RockingRidz/StreamPixel/PCB/StreamPixel-perfboard.pdf

1 | 2 | 3 | 4 | 5 | 6 | 7 | 8
1 | 2 | 3 | 4 | 5 | 6 | 7 | 8

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
Size: A3 | Rev: 1 | F Date: 2026-11-01
KiCad E.D.A. 10.0.6 | Id: 1/1

# Title: StreamPixel - development-board / perfboard wiring

## File: StreamPixel-perfboard.kicad_sch

## Sheet: /

## Ridith Shetty

NO CUSTOM PCB REQUIRED. Logical module pin labels; verify actual hardware.

GND GND | OUT | OUT VCC VCC | U4 MAX9814 - follow printed pin labels 1

2

J6 Panel 2 DC power lead

C3

## 470uF 25V - polarity matters F3

5A candidate - verify branch load

C1

## 100nF at U2 pins20/10

1
2
3
J4 PIN8: select GND OR E after verification | 1

2

J7 Panel 3 DC power lead

F4

5A candidate - verify branch load

C2

## 100nF at U3 pins20/10

1
2

J5 Panel 1 DC power lead

1 | 2
3 | 4
5 | 6
7 | 8
9 | 10
11 | 12
13 | 14
15 | 16

## J1 HUB75 PANEL 1 IN - VERIFY PINOUT

F2

5A candidate - verify branch load

3V3 3V3 | 5V/VIN 5V | GND GND | GPIO13 | GPIO13 GPIO14 | GPIO14 GPIO16 | GPIO16 GPIO17 | GPIO17 GPIO18 | GPIO18 GPIO19 | GPIO19 GPIO21 | GPIO21 GPIO22 | GPIO22 GPIO23 | GPIO23 GPIO25 | GPIO25 GPIO26 | GPIO26 GPIO27 | GPIO27 GPIO32 | GPIO32 GPIO33 GPIO34_ADC1 | GPIO33 GPIO34 | U1

## ESP32 30-pin dev board - GPIO LABELS

DIR 1 | A1 2 | A2 3 | A3 4 | A4 5 | A5 6 | A6 7 | A7 8 | A8 9 | GND 10 | B8 | 11 B7 | 12 B6 | 13 B5 | 14 B4 | 15 B3 | 16 B2 | 17 B1 | 18 OE 19 | VCC 20 U2
SN74HCT245N (A-to-B) DIR 1 | A1 2 | A2 3 | A3 4 | A4 5 | A5 6 | A6 7 | A7 8 | A8 9 | GND 10 | B8 | 11 B7 | 12 B6 | 13 B5 | 14 B4 | 15 B3 | 16 B2 | 17 B1 | 18 OE 19 | VCC 20 U3

## SN74HCT245N (A-to-B) R1

## 10k OE blank at reset 1

2

J2

## 5V DC from protected supply - NO MAINS HERE

F1

1A controller

ADDR_A | R1 | G1 B1R2 | GND
B2 | G2
ADDR_A GPIO14 | GND

ADDR_C

CLK

PANEL_PIN8 | +5V_CTRL GND

GND

GND

ADDR_E | +5V_CTRL +3V3 GND

GND

PANEL3_5V

+5V_CTRL

PANEL1_5V | +5V_SUPPLY

+5V_CTRL

PANEL2_5V GND

GPIO33

PANEL2_5V

GND

# PANEL3_5V +5V_SUPPLY

GPIO25 | MIC_AUDIO

GND

GND

GND

PANEL_PIN8

ADDR_B

ADDR_D

+5V_CTRL

GPIO26

+5V_SUPPLY

GPIO27 | GND

PANEL1_5V

MIC_AUDIO

G1 GPIO13 GPIO32 GPIO23 GPIO19 GPIO18 GPIO21 GPIO16 GPIO17 GPIO22 | GND
GND +5V_CTRL GPIO21 GPIO16 +5V_CTRL GPIO23 GPIO19 | +5V_CTRL | R1

ADDR_B

GPIO25 | B1

LAT R2 GPIO27 GPIO14 GPIO13 GPIO32 +5V_CTRL GND

GND

GPIO18 +3V3

ADDR_C

ADDR_D

CLK

LAT DISPLAY_OE

GPIO26 GPIO17 GPIO22 GPIO33 +3V3 GPIO22

G2

GND +5V_SUPPLY +5V_SUPPLY

DISPLAY_OE B2

+5V_SUPPLY +5V_CTRL GND

ADDR_E 5V buffer outputs NEVER connect to ESP32 inputs. U2/U3 must be HCT parts, not HC-only replacements.

Panel OUT -> next panel IN. Separate fused power to every panel. Do not carry panel current through perfboard.

J4 stays open until panel pin8 is identified. Never bridge both positions or ground a driven E output. MAX9814 powered at 3.3V; verify actual output range before connecting GPIO34 (ADC1).

# StreamPixel | Ridith Shetty | PERFBOARD BUILD - NO PCB ORDER

Supply case and terminals require suitable protection, earth and strain relief. This sheet covers LOW-VOLTAGE DC wiring only. Disconnect external supply and display harness for USB programming unless dev-board power isolation is documented.

GPIO labels are logical connections, NOT a physical 30-pin header drawing. Verify the actual board labels.
