RockingRidz/StreamPixel/BOM.csv

Item | Qty | Supplier | Cost/item | Total Cost | link
P10 RGB 2727 320x160 panel | 3 | Koshi | $6.85 | $20.55 | https://koshielectronics.in/products/p10-rgb-led-module?variant=43978032611524
5V 20A slim SMPS | 1 | Koshi | $5.78 | $5.78 | https://koshielectronics.in/products/xps-smps-5v-10a?variant=44089885327556
Nylon Cable Tie / Wire Tag 200X3.6mm (Pack of 100) | 1 | Quartz | $1.04 | $1.04 | https://quartzcomponents.com/products/tie-250x3-6-100-pc-in-each?variant=44025622003946
M3 x 8mm Flat SS Washer (Inner Dia. 3mm) | 24 | Quartz | $0.02 | $0.48 | https://quartzcomponents.com/products/m3-zinc-plated-steel-washer?variant=45646474346730
M3-15mm Bolt with Phillips Head (Mounting Screw) - Pack of 4 | 1 | Quartz | $0.08 | $0.08 | https://quartzcomponents.com/products/phillips-head-m3-15mm-bolt-mounting-screw-for-pcb-pack-of-4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
Phillips Head M3- 25mm bolt (Mounting Screw for PCB) - Pack of 4 | 1 | Quartz | $0.11 | $0.11 | https://quartzcomponents.com/products/phillips-head-m3-25mm-bolt-mounting-screw-for-pcb-pack-of-4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
MAX9814 High Performance AGC Microphone Amplifier Module CMA-4544PF-W | 1 | Quartz | $2.33 | $2.33 | https://quartzcomponents.com/products/max9814-agc-microphone-amplifier-module-cma-4544pf-w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
M3 Hex Nut with 2mm height (pack of 4) | 8 | Quartz | $0.12 | $0.96 | https://quartzcomponents.com/products/m3-hex-nut-with-2mm-height-pack-of-4?variant=42673973133546
M3-10mm Bolt with Phillips Head(Mounting Screw for PCB) - Pack of 4 | 6 | Quartz | $0.08 | $0.48 | https://quartzcomponents.com/products/phillips-head-m3-10mm-bolt-mounting-screw-for-pcb?variant=42673975886058
PG9 Cable Gland Connector (DIA-15mm)- Plastic Nylon Gland - Black | 1 | Quartz | $0.05 | $0.05 | https://quartzcomponents.com/products/pg9-cable-gland-connector-dia-15mm-plastic-nylon-gland-black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
Heat Shrink Sleeve Tube - 5mm Diameter - Black - 1 meter | 1 | Quartz | $0.20 | $0.20 | https://quartzcomponents.com/products/heat-shrink-tube-5mm-diameter-black-1-meter?variant=37554769756344
1A Glass Fuse - 5x20mm | 1 | Quartz | $0.05 | $0.05 | https://quartzcomponents.com/products/1a-glass-fuse-5x20mm?variant=31898062028935
5A Glass Fuse - 5x20mm | 3 | Quartz | $0.04 | $0.12 | https://quartzcomponents.com/products/5a-glass-fuse-5x20mm?variant=31898062684295
Panel Mount 5A Fuse Holder (5x20MM) | 4 | Quartz | $0.19 | $0.76 | https://quartzcomponents.com/products/panel-mount-5a-fuse-holder-5x20mm?variant=40656589029560
3 Pin Power Supply AC Extension Cord Power Cable 180v to 240v AC 10A - 1.3 meter | 1 | Quartz | $1.42 | $1.42 | https://quartzcomponents.com/products/3-pin-power-supply-ac-extension-cord-power-cable-180v-to-240v-ac-10a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
18AWG Silicone Wire Black ( 1 meter ) - High Quality Ultra Flexible for Battery Packs | 2 | Quartz | $0.44 | $0.88 | https://quartzcomponents.com/products/high-quality-ultra-flexible-18awg-silicone-wire-black-1-meter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
18AWG Silicone Wire Red ( 1 meter ) - High Quality Ultra Flexible for Battery Packs | 2 | Quartz | $0.44 | $0.88 | https://quartzcomponents.com/products/high-quality-ultra-flexible-18awg-silicone-wire-red-1-meter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
23AWG Single Strand Breadboard Connecting Wire (Black and Red - 1+1 Meter) | 1 | Quartz | $0.26 | $0.26 | https://quartzcomponents.com/products/breadboard-connecting-wires-1-1-meter?variant=32394483105927
Samwha 470uF 25V 85 Degree Radial Electrolytic Capacitor - Through Hole | 1 | Quartz | $0.08 | $0.08 | https://quartzcomponents.com/products/samwha-470uf-25v-85-c-radial-electrolytic-capacitor-through-hole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
10K ohm, 1/4 Watt Resistor with 5% tolerance (Pack of 10) | 1 | Quartz | $0.07 | $0.07 | https://quartzcomponents.com/products/10k-ohm-1-4-watt-resistor?variant=31898016710791
40 Pin Straight Female Header Pins - Berg Strips | 1 | Quartz | $0.11 | $0.11 | https://quartzcomponents.com/products/40-pin-straight-female-berg-strips?variant=31898065830023
40 Pin Straight Male Header Pins - Berg Strips | 1 | Quartz | $0.07 | $0.07 | https://quartzcomponents.com/products/40-pin-break-away-headers-straight-male-headers?variant=31898065633415
100nF / 0.1uF (104) 50V 1206 SMD Capacitor (Pack of 10 Pieces) | 1 | Quartz | $0.17 | $0.17 | https://quartzcomponents.com/products/100nf-0-1uf-104-50v-1206-smd-capacitor-pack-of-10-pieces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
USB to micro-USB Cable for NodeMCU and Raspberry Pi | 1 | Quartz | $0.34 | $0.34 | https://quartzcomponents.com/products/raspberry-pi-cable-for-charging?variant=31897766428807
9x15cm Double Sided Universal PCB Prototype Board | 1 | Quartz | $1.14 | $1.14 | https://quartzcomponents.com/products/double-sided-universal-pcb-prototype-board-9x15cm?variant=45108700840170
ESP32 30 Pin CP2102 Development Board with Wi-Fi and Bluetooth | 1 | Quartz | $3.95 | $3.95 | https://quartzcomponents.com/products/esp32-30-pin-development-board-with-wi-fi-and-bluetooth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
SN74HCT245N DIP20 | 2 | Industrybuying | $1.47 | $2.94 | https://www.industrybuying.com/industrial-automation-accessories-texas-instruments-IND.IND.231558858
Buffer cart delivery | 1 | Industrybuying | $3.14 | $3.14 | https://www.industrybuying.com/order/cart
Estimated total shipping | 1 |  |  | $19.00
