RockingRidz/StreamPixel/CAD/CNC/Whole-frame-990x190x60.step

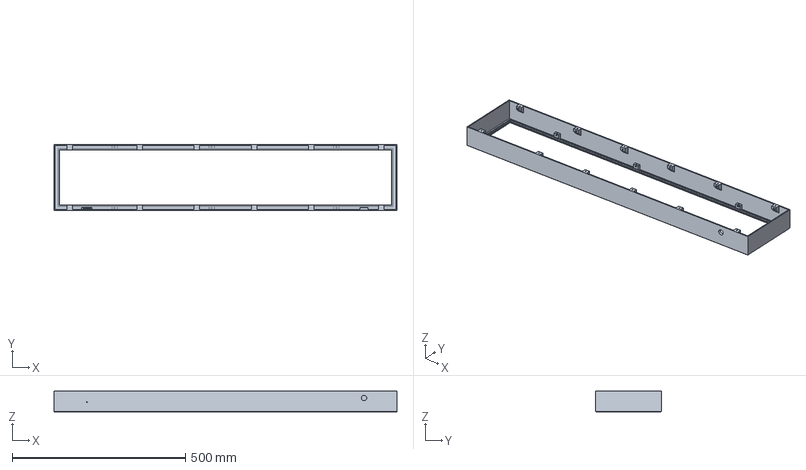
[picture p5: CAD file, 2026-11-01]
CAD/CNC/Whole-frame-990x190x60.step
990.0 x 190.0 x 60.0 mm
