RockingRidz/StreamPixel/CAD/CNC/REFERENCE-ONLY-frame-overall.dxf

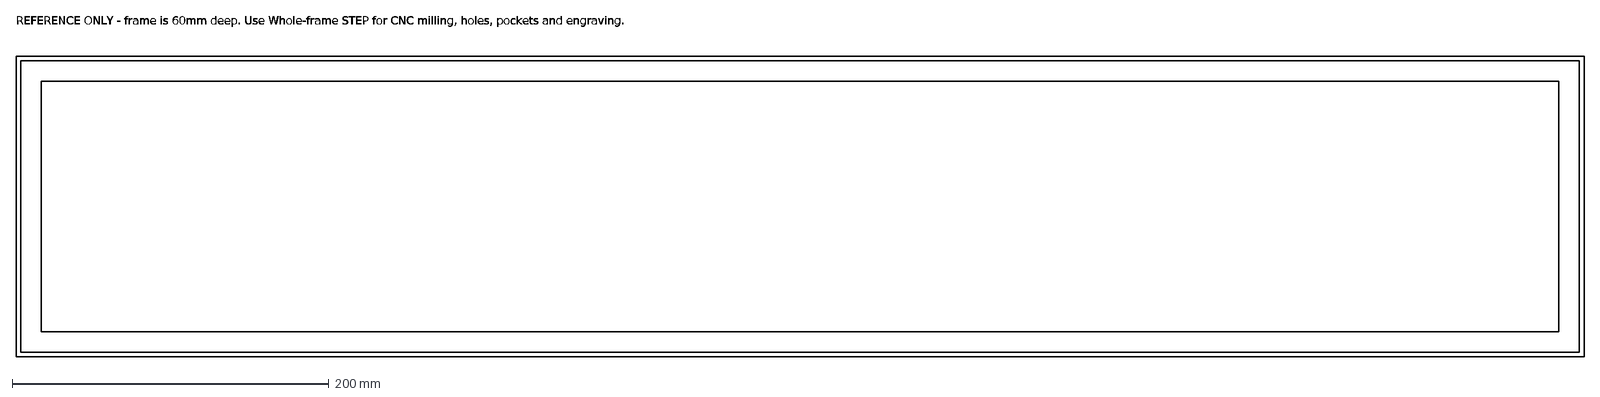
[picture p6: CAD file, 2026-11-01]
CAD/CNC/REFERENCE-ONLY-frame-overall.dxf
REFERENCE ONLY - frame is 60mm deep. Use Whole-frame STEP for CNC milling, holes, pockets and engraving.
