RockingRidz/StreamPixel/CAD/CNC/Whole-backplate-990x190x3.step

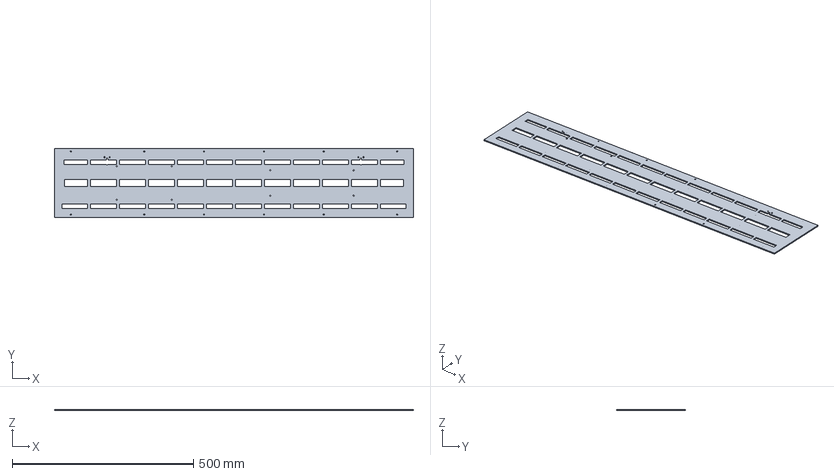
[picture p7: CAD file, 2026-11-01]
CAD/CNC/Whole-backplate-990x190x3.step
990.0 x 190.0 x 3.00 mm
