RockingRidz/StreamPixel/CAD/3D_PRINTED/Supply-holder-right.step

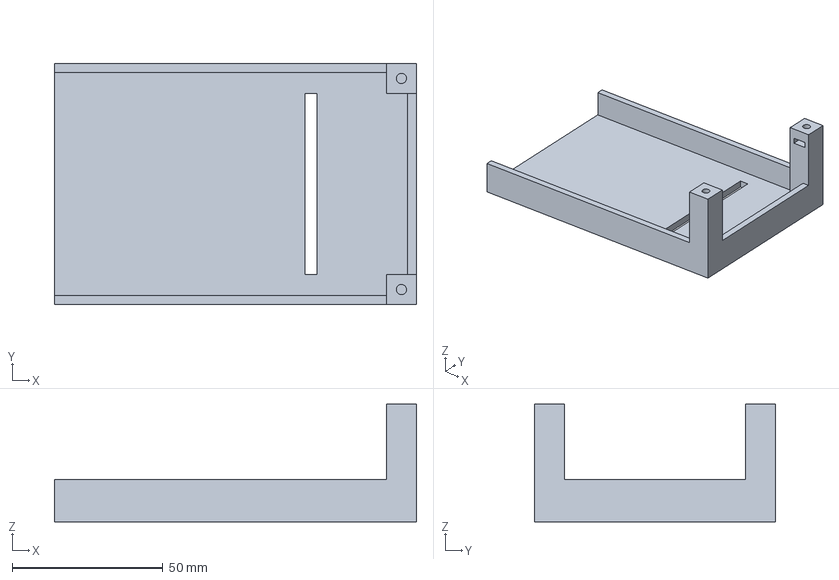
[picture p8: CAD file, 2026-11-01]
CAD/3D_PRINTED/Supply-holder-right.step
120.0 x 80.0 x 39.0 mm
