RockingRidz/StreamPixel/CAD/SOURCE/StreamPixel-Ridith-Shetty.FCStd

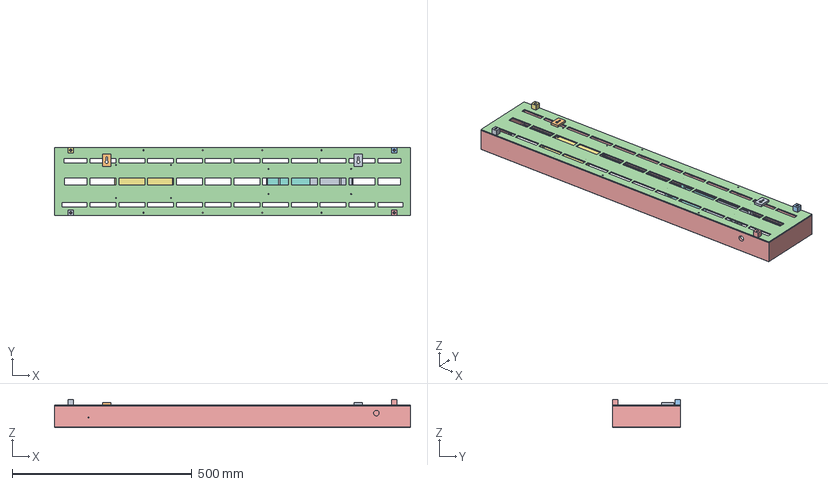
[picture p9: CAD file, 2026-11-01]
CAD/SOURCE/StreamPixel-Ridith-Shetty.FCStd
990.0 x 190.0 x 78.0 mm
Hanger-pad-X350-Y59
Hanger-pad-X-350-Y59
Panel-retainer-X320-Y83
Whole-backplate-990x190x3
Whole-frame-990x190x60
Panel-retainer-X-40-Y-83
Wall-spacer-X-450-Y87
Panel-retainer-X320-Y-83
Wall-spacer-X-450-Y-87
Panel-retainer-X-40-Y83
Wall-spacer-X450-Y87
Panel-retainer-X-320-Y83
Wall-spacer-X450-Y-87
Panel-retainer-X-320-Y-83
Controller-tray
Supply-holder-left
Supply-holder-right
