RockingRidz/StreamPixel/CAD/CNC/Hanger-pad-X-350-Y59.step

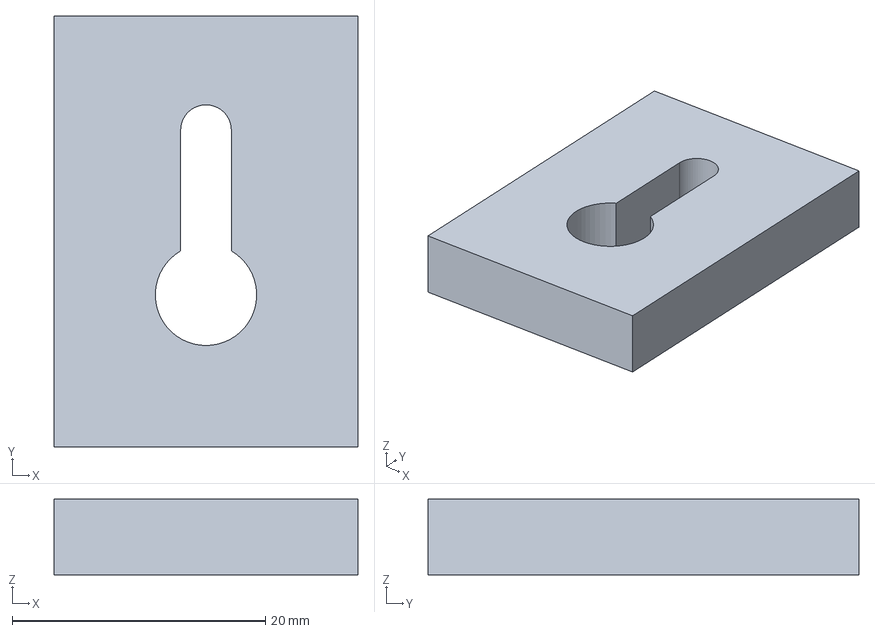
[picture p10: CAD file, 2026-11-01]
CAD/CNC/Hanger-pad-X-350-Y59.step
24.0 x 34.0 x 6.00 mm
