RockingRidz/StreamPixel/CAD/SOURCE/CNC-components.step

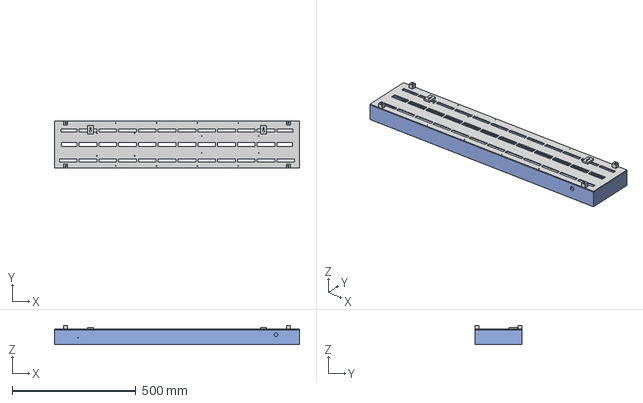
[picture p11: CAD file, 2026-11-01]
CAD/SOURCE/CNC-components.step
990.0 x 190.0 x 78.0 mm
