RockingRidz/StreamPixel/CAD/3D_PRINTED/Controller-tray.step

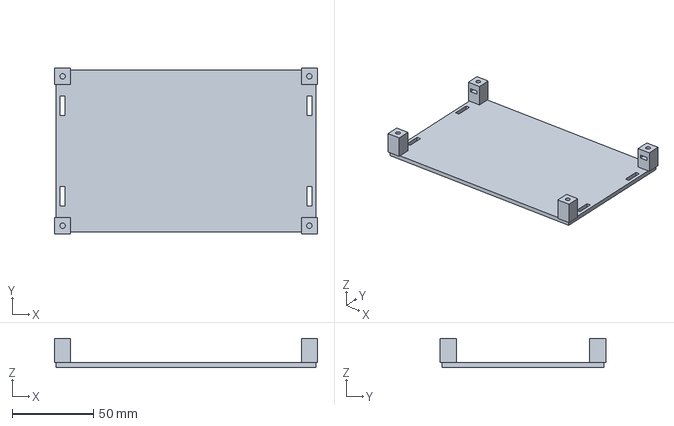
[picture p12: CAD file, 2026-11-01]
CAD/3D_PRINTED/Controller-tray.step
162.0 x 102.0 x 18.0 mm
