RockingRidz/StreamPixel/CAD/CNC/Panel-retainer-X-320-Y-83.step

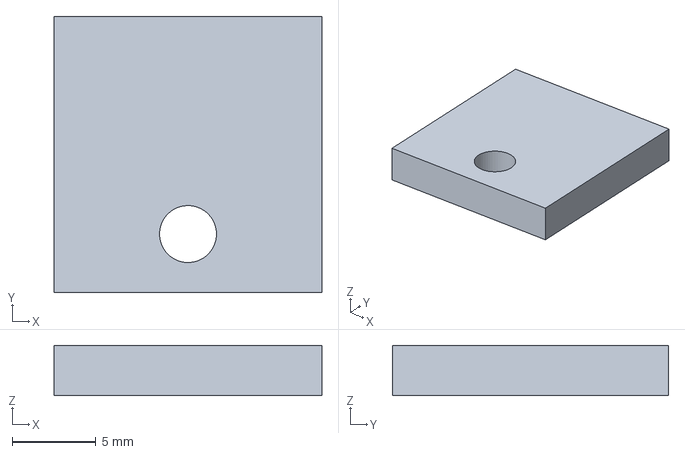
[picture p13: CAD file, 2026-11-01]
CAD/CNC/Panel-retainer-X-320-Y-83.step
16.0 x 16.5 x 3.00 mm
