RockingRidz/StreamPixel/CAD/SOURCE/PRINT-holders.step

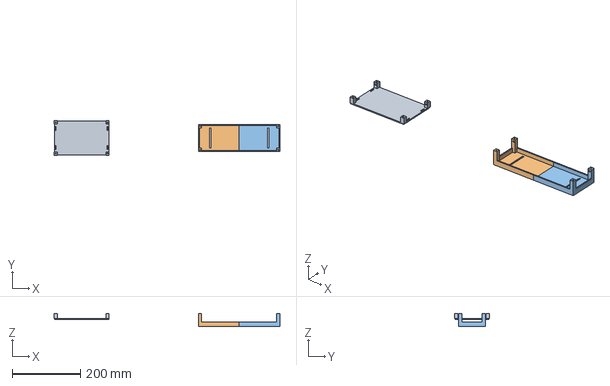
[picture p14: CAD file, 2026-11-01]
CAD/SOURCE/PRINT-holders.step
663.5 x 102.0 x 39.0 mm
