RockingRidz/StreamPixel/CAD/CNC/Wall-spacer-X-450-Y-87.step

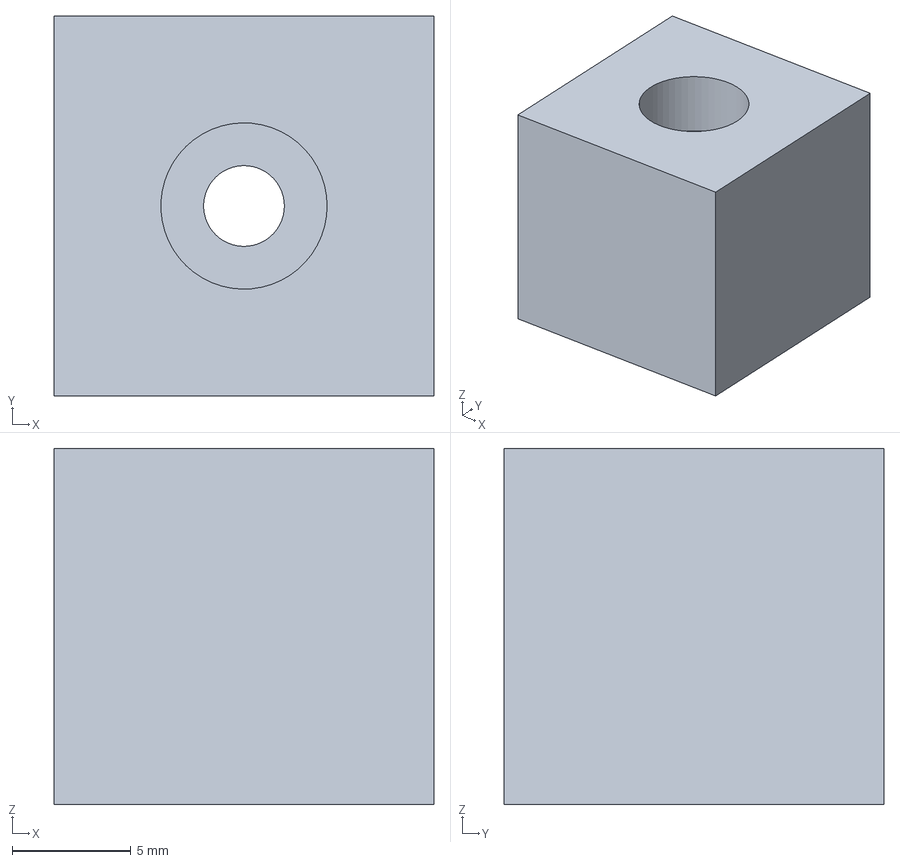
[picture p15: CAD file, 2026-11-01]
CAD/CNC/Wall-spacer-X-450-Y-87.step
16.0 x 16.0 x 15.0 mm
