RockingRidz/StreamPixel/(list of files, cad)

Other CAD files:
CAD/3D_PRINTED/Supply-holder-left.step
CAD/CNC/Panel-retainer-X-40-Y-83.step
CAD/3D_PRINTED/Controller-tray.stl
CAD/3D_PRINTED/Supply-holder-left.stl
CAD/3D_PRINTED/Supply-holder-right.stl
CAD/CNC/Hanger-pad-X350-Y59.step
CAD/CNC/Panel-retainer-X-320-Y-83.dxf
CAD/CNC/Panel-retainer-X-320-Y83.dxf
CAD/CNC/Panel-retainer-X-320-Y83.step
CAD/CNC/Panel-retainer-X-40-Y-83.dxf
CAD/CNC/Panel-retainer-X-40-Y83.dxf
CAD/CNC/Panel-retainer-X-40-Y83.step
CAD/CNC/Panel-retainer-X320-Y-83.dxf
CAD/CNC/Panel-retainer-X320-Y-83.step
CAD/CNC/Panel-retainer-X320-Y83.dxf
CAD/CNC/Panel-retainer-X320-Y83.step
CAD/CNC/Wall-spacer-X-450-Y87.step
CAD/CNC/Wall-spacer-X450-Y-87.step
CAD/CNC/Wall-spacer-X450-Y87.step
CAD/CNC/Whole-backplate-990x190x3.dxf
