RockingRidz/StreamPixel/PCB/StreamPixel-perfboard.kicad_sch

## KiCad design PCB/StreamPixel-perfboard.kicad_sch (2026-11-01)

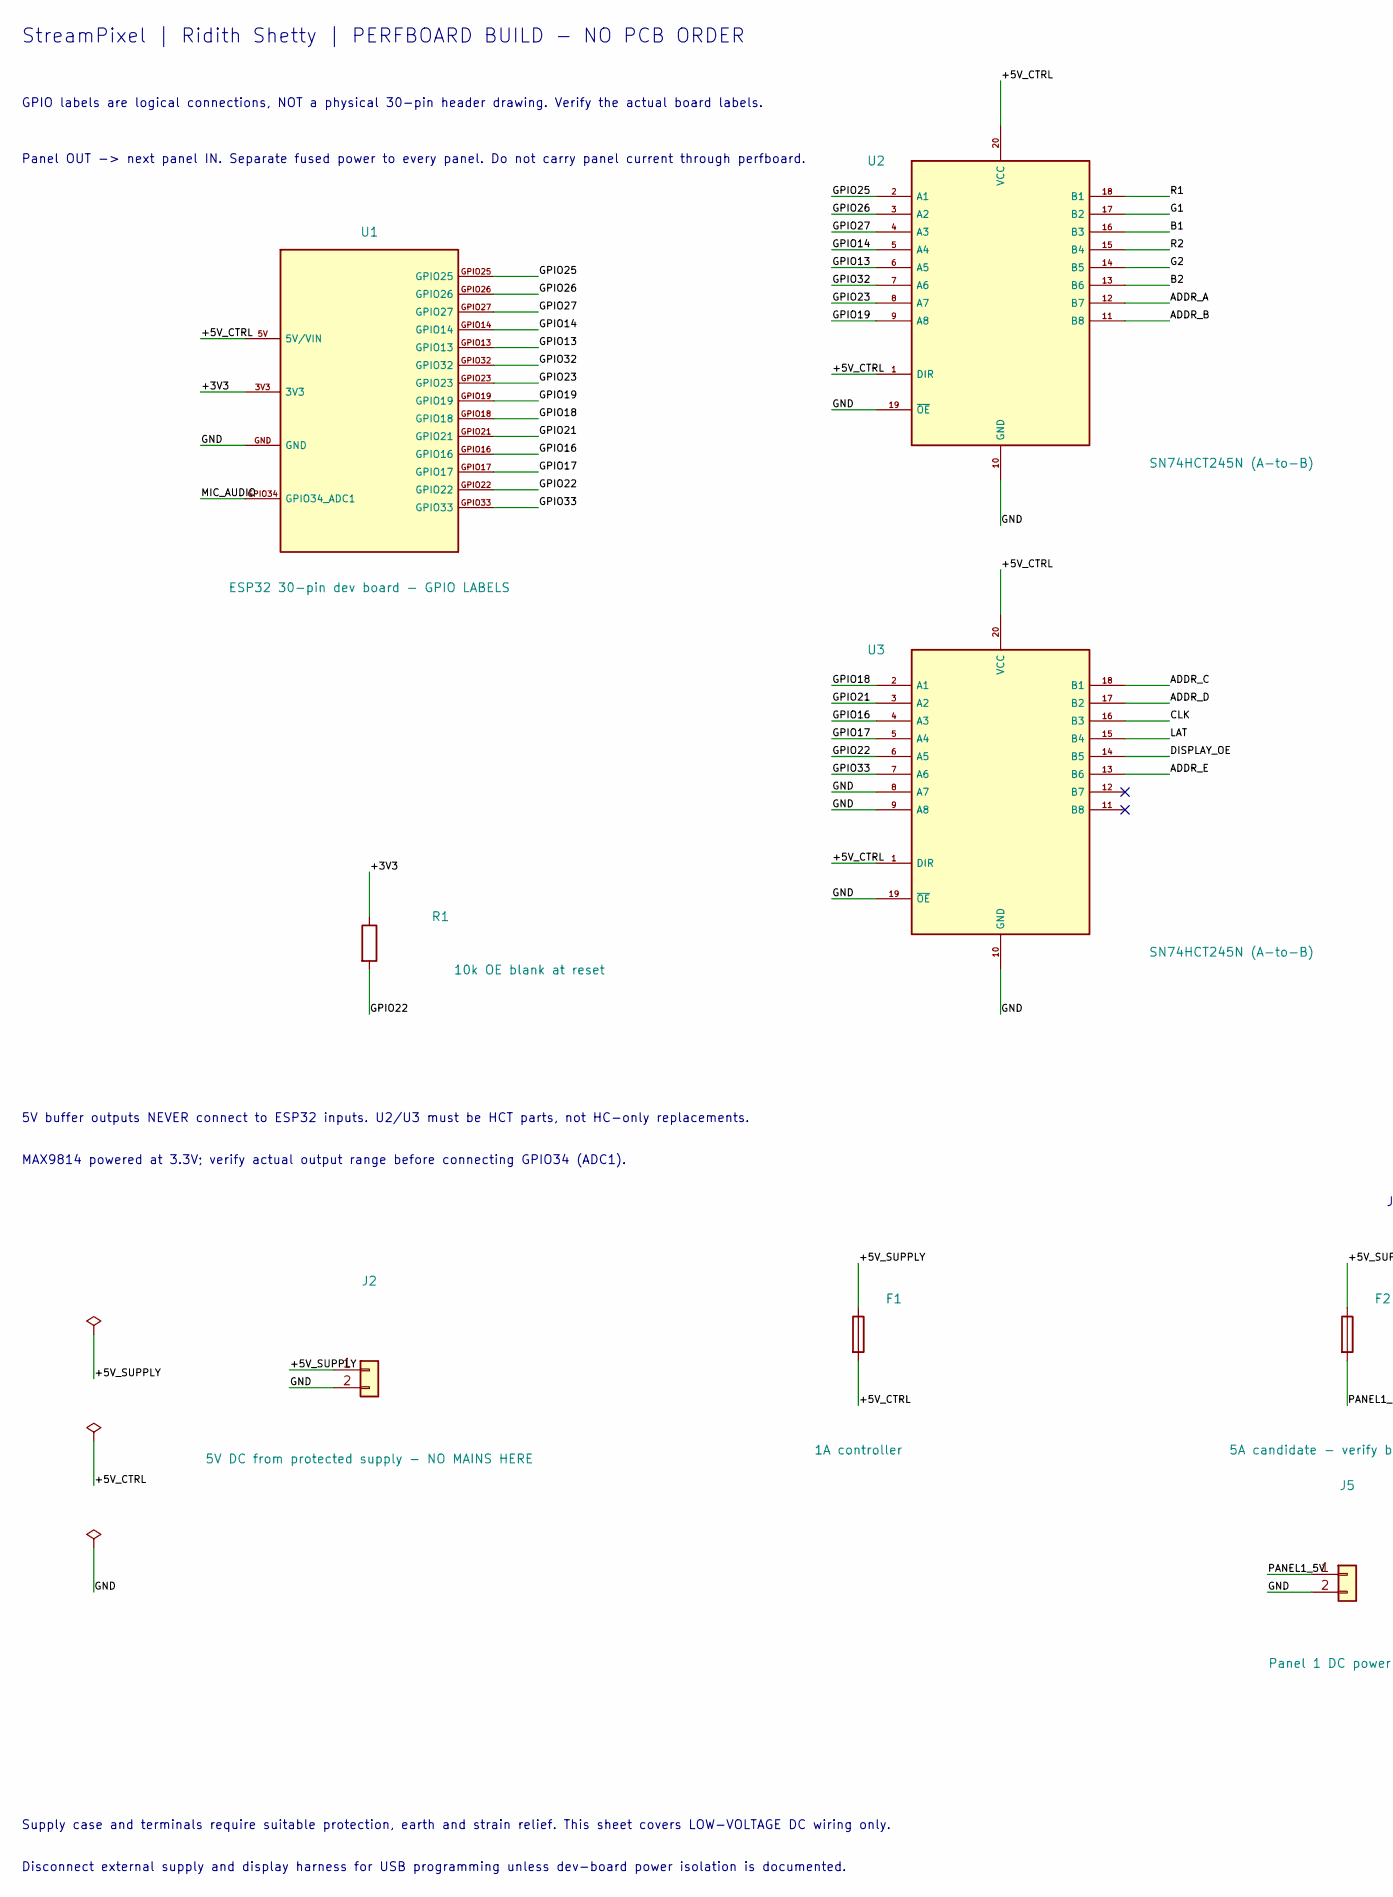
[picture p16: schematic StreamPixel-perfboard.kicad_sch, part in row 1, column 1]

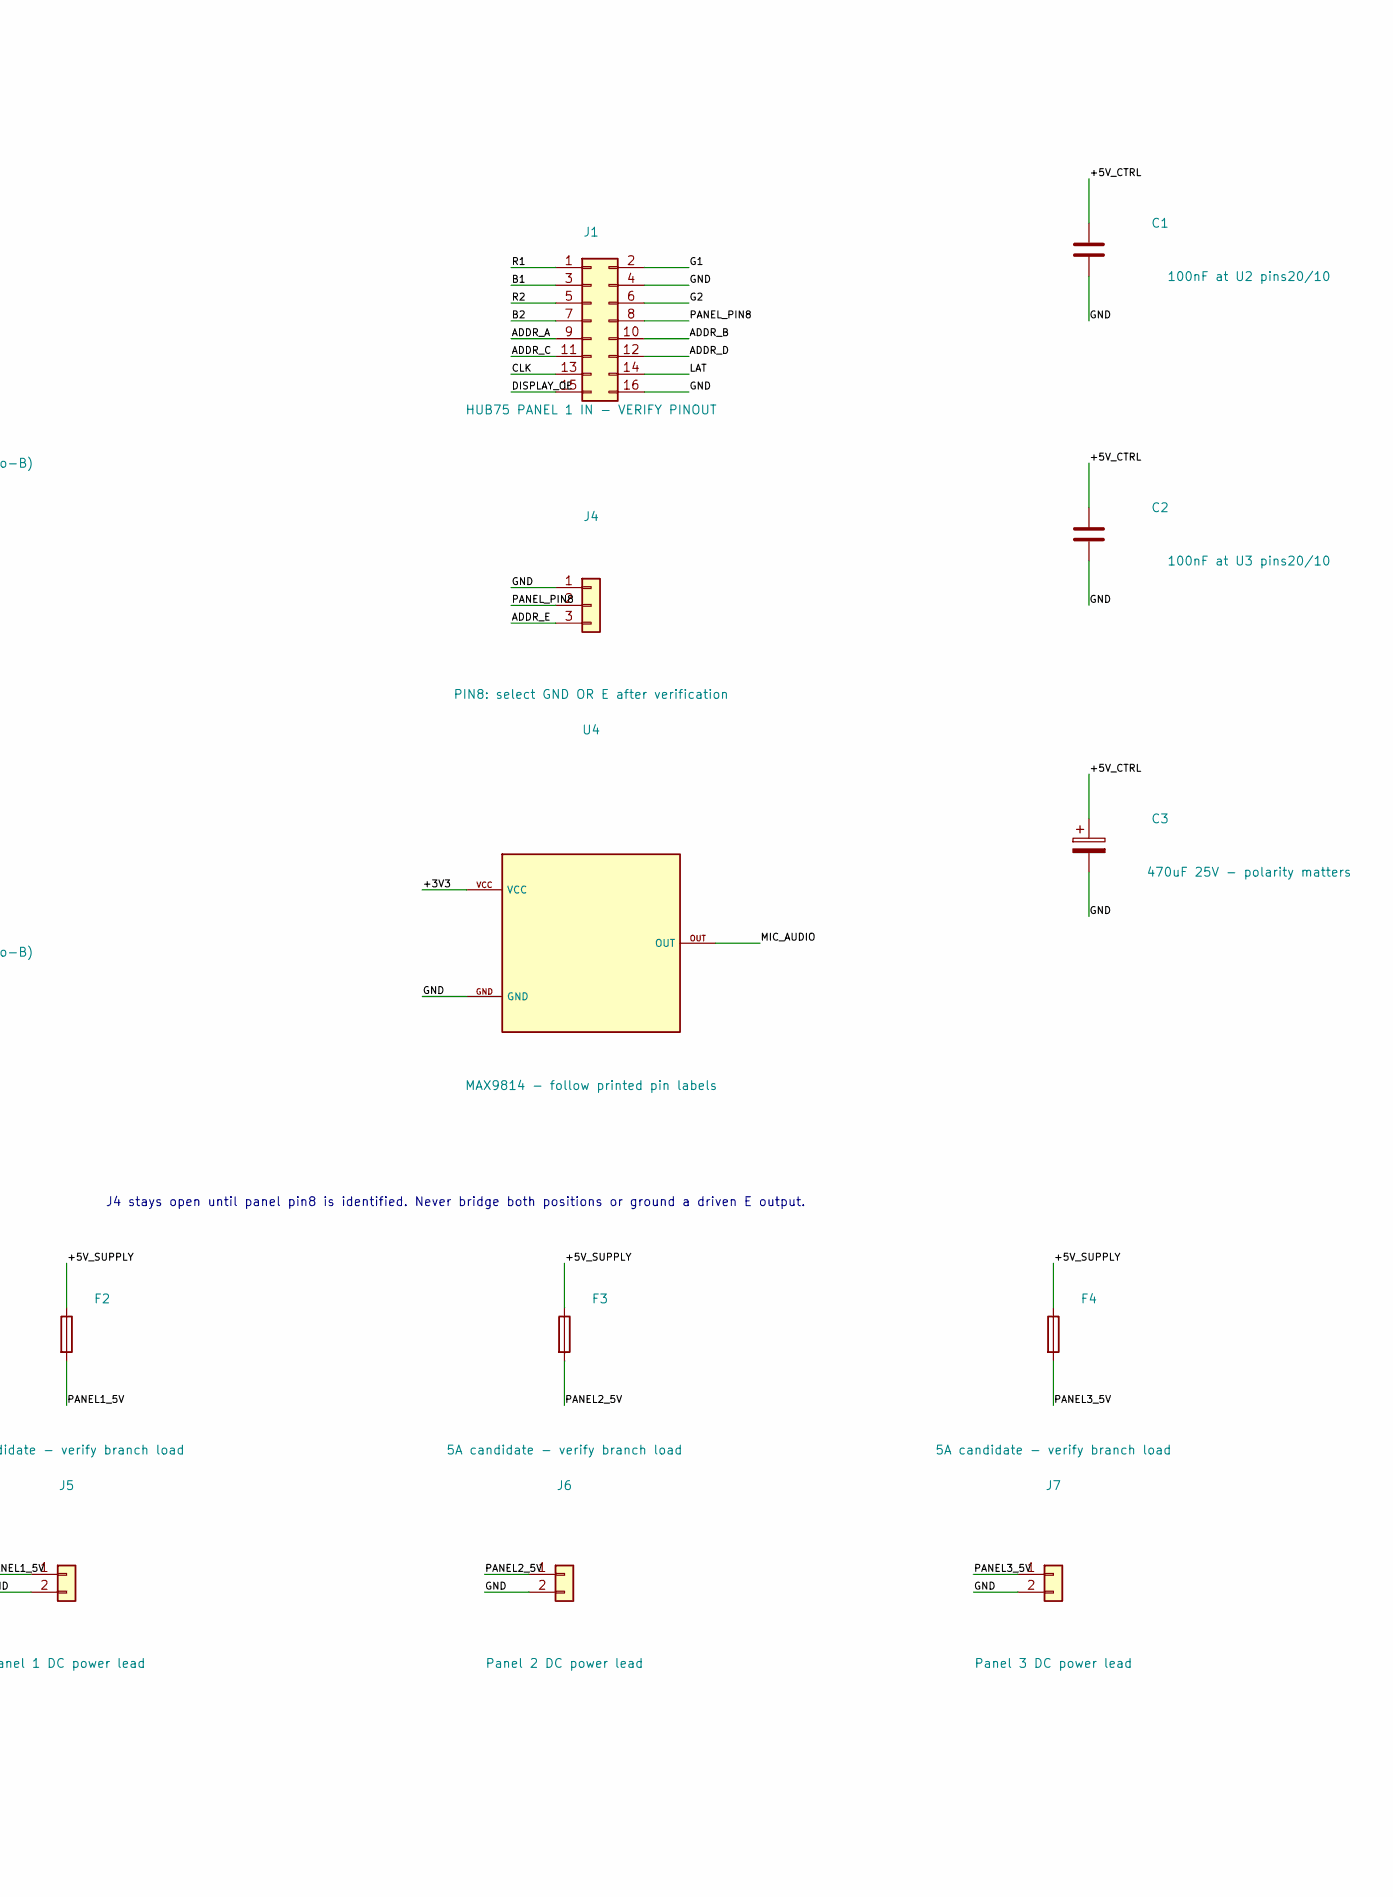
[picture p17: schematic StreamPixel-perfboard.kicad_sch, part in row 1, column 2]

Parts:
C1: 100nF at U2 pins20/10
C2: 100nF at U3 pins20/10
C3: 470uF 25V - polarity matters
F1: 1A controller
F2, F3, F4: 5A candidate - verify branch load
J1: HUB75 PANEL 1 IN - VERIFY PINOUT
J2: 5V DC from protected supply - NO MAINS HERE
J4: PIN8: select GND OR E after verification
J5: Panel 1 DC power lead
J6: Panel 2 DC power lead
J7: Panel 3 DC power lead
R1: 10k OE blank at reset
U1: ESP32 30-pin dev board - GPIO LABELS
U2, U3: SN74HCT245N (A-to-B)
U4: MAX9814 - follow printed pin labels

Connections:
+3V3: R1.1, U1.3V3, U4.VCC
+5V_CTRL: C1.1, C2.1, C3.1, F1.2, U1.5V (5V/VIN), U2.1 (DIR), U2.20 (VCC), U3.1 (DIR), U3.20 (VCC)
+5V_SUPPLY: F1.1, F2.1, F3.1, F4.1, J2.1
ADDR_A: J1.9, U2.12 (B7)
ADDR_B: J1.10, U2.11 (B8)
ADDR_C: J1.11, U3.18 (B1)
ADDR_D: J1.12, U3.17 (B2)
ADDR_E: J4.3, U3.13 (B6)
B1: J1.3, U2.16 (B3)
B2: J1.7, U2.13 (B6)
CLK: J1.13, U3.16 (B3)
DISPLAY_OE: J1.15, U3.14 (B5)
G1: J1.2, U2.17 (B2)
G2: J1.6, U2.14 (B5)
GND: C1.2, C2.2, C3.2, J1.4, J1.16, J2.2, J4.1, J5.2, J6.2, J7.2, U1.GND, U2.10 (GND), U2.19 (~OE), U3.8 (A7), U3.9 (A8), U3.10 (GND), U3.19 (~OE), U4.GND
GPIO13: U1.GPIO13, U2.6 (A5)
GPIO14: U1.GPIO14, U2.5 (A4)
GPIO16: U1.GPIO16, U3.4 (A3)
GPIO17: U1.GPIO17, U3.5 (A4)
GPIO18: U1.GPIO18, U3.2 (A1)
GPIO19: U1.GPIO19, U2.9 (A8)
GPIO21: U1.GPIO21, U3.3 (A2)
GPIO22: R1.2, U1.GPIO22, U3.6 (A5)
GPIO23: U1.GPIO23, U2.8 (A7)
GPIO25: U1.GPIO25, U2.2 (A1)
GPIO26: U1.GPIO26, U2.3 (A2)
GPIO27: U1.GPIO27, U2.4 (A3)
GPIO32: U1.GPIO32, U2.7 (A6)
GPIO33: U1.GPIO33, U3.7 (A6)
LAT: J1.14, U3.15 (B4)
MIC_AUDIO: U1.GPIO34 (GPIO34_ADC1), U4.OUT
PANEL1_5V: F2.2, J5.1
PANEL2_5V: F3.2, J6.1
PANEL3_5V: F4.2, J7.1
PANEL_PIN8: J1.8, J4.2
R1: J1.1, U2.18 (B1)
R2: J1.5, U2.15 (B4)

Notes on the sheet:
StreamPixel | Ridith Shetty | PERFBOARD BUILD - NO PCB ORDER
GPIO labels are logical connections, NOT a physical 30-pin header drawing. Verify the actual board labels.
Panel OUT -> next panel IN. Separate fused power to every panel. Do not carry panel current through perfboard.
5V buffer outputs NEVER connect to ESP32 inputs. U2/U3 must be HCT parts, not HC-only replacements.
MAX9814 powered at 3.3V; verify actual output range before connecting GPIO34 (ADC1).
J4 stays open until panel pin8 is identified. Never bridge both positions or ground a driven E output.
Supply case and terminals require suitable protection, earth and strain relief. This sheet covers LOW-VOLTAGE DC wiring only.
Disconnect external supply and display harness for USB programming unless dev-board power isolation is documented.
