RockingRidz/StreamPixel/(commit log)

2026-10-31 Sync StreamPixel from Half Life
    [BOM.csv]
2026-11-01 Separate printed and acrylic CAD, export DXFs, and organize project files
    [01-Frame-section-6-end---fit-review.stl, 02-Rail-splice-plate-1---M3x10-and-two-nuts.stl, 03-Frame-section-5-top---fit-review.stl, 04-Frame-section-3-top---fit-review.stl, 05-Hanger-pad-X-350---two-M3x16.stl, 06-Frame-section-4-top---fit-review.stl, 07-Panel-retainer-6---measured-height-required.stl, 08-Wall-spacer-X450-Y87---M3x25.stl]
2026-11-01 Finalize CNC frame, printed holders, perfboard schematic and firmware
    [01-Frame-section-6-end---fit-review.stl, 02-Rail-splice-plate-1---M3x10-and-two-nuts.stl, 03-Frame-section-5-top---fit-review.stl, 04-Frame-section-3-top---fit-review.stl, 05-Hanger-pad-X-350---two-M3x16.stl, 06-Frame-section-4-top---fit-review.stl, 07-Panel-retainer-6---measured-height-required.stl, 08-Wall-spacer-X450-Y87---M3x25.stl]
2026-11-01 Update parts prices and quantities from current carts
    [BOM.csv]
2026-11-01 Preserve priced parts list after journal sync and update budget
    [BOM.csv]
